phorton1/Arduino-boat-airco/docs/3dp/drain_straight_top.3mf

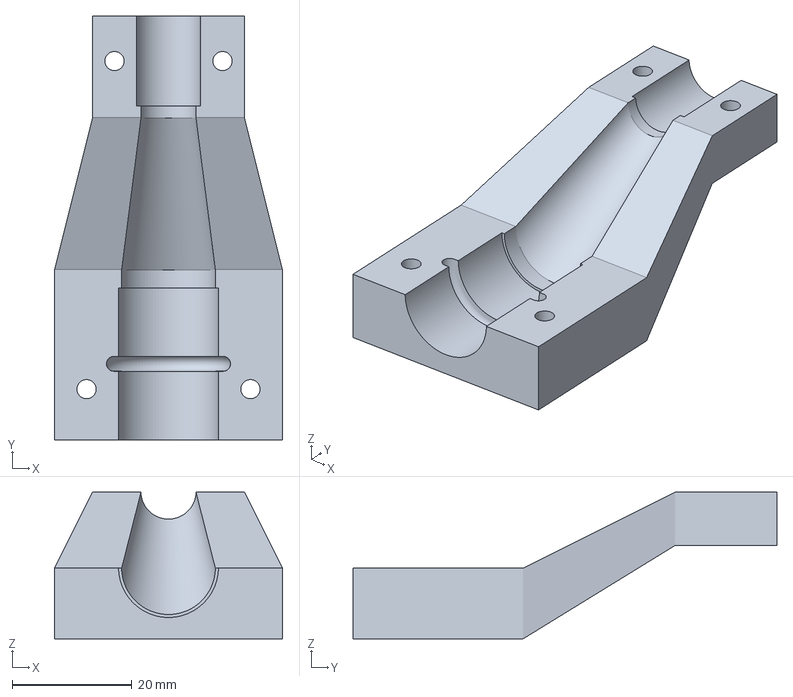
[picture p1: CAD file, 2026-03-28]
docs/3dp/drain_straight_top.3mf
38.1 x 70.8 x 24.5 mm
