phorton1/Arduino-boat-airco/docs/3dp/drain_angled_top.3mf

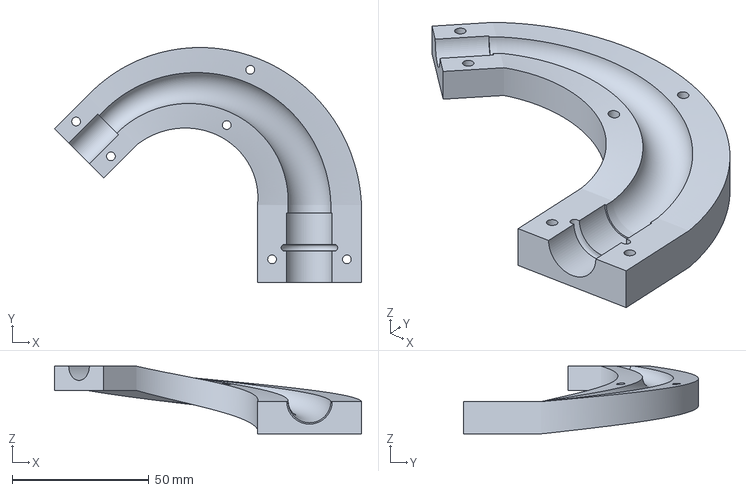
[picture p2: CAD file, 2026-03-28]
docs/3dp/drain_angled_top.3mf
112.4 x 86.0 x 24.8 mm
