phorton1/Arduino-boat-airco/docs/3dp/closet_box_cover.3mf

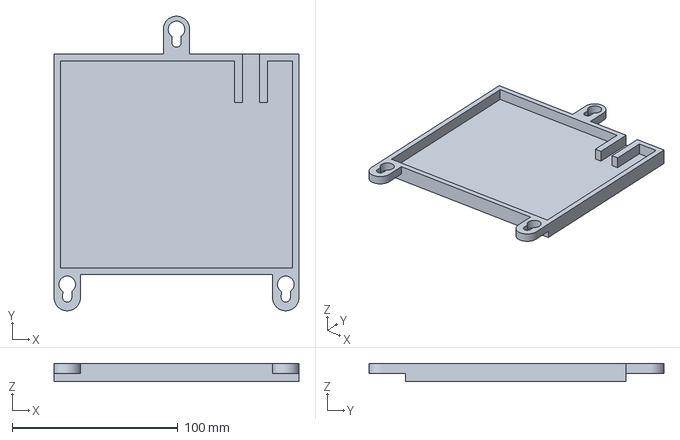
[picture p3: CAD file, 2026-03-28]
docs/3dp/closet_box_cover.3mf
148.0 x 178.0 x 11.0 mm
