phorton1/Arduino-boat-airco/docs/3dp/drain_straight_bottom.3mf

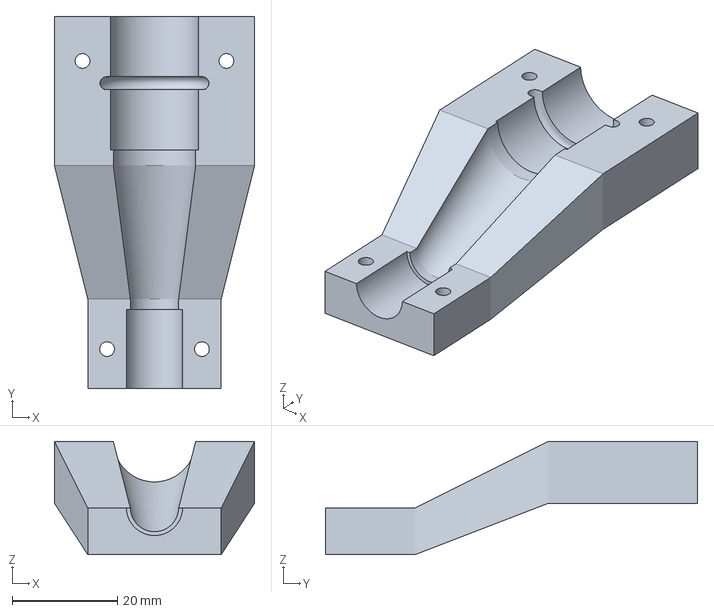
[picture p4: CAD file, 2026-03-28]
docs/3dp/drain_straight_bottom.3mf
38.1 x 70.8 x 21.6 mm
