phorton1/Arduino-boat-airco/docs/3dp/led_holder.3mf

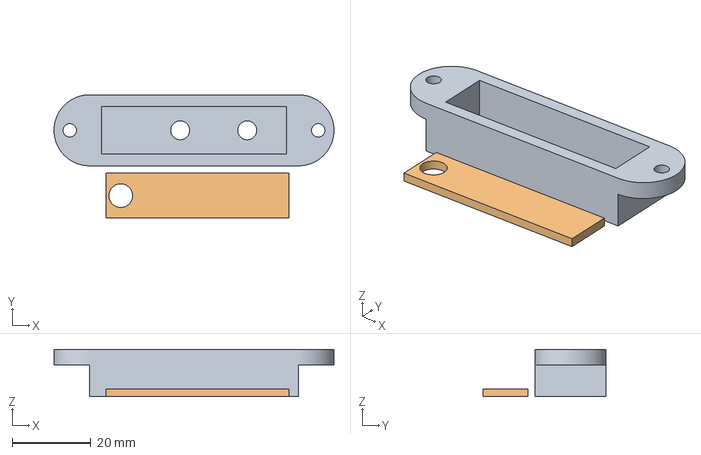
[picture p5: CAD file, 2026-03-04]
docs/3dp/led_holder.3mf
71.0 x 31.3 x 12.0 mm
led_holder.stl
led_holder2.stl
