phorton1/Arduino-boat-airco/docs/3dp/sensor_clamp.stl

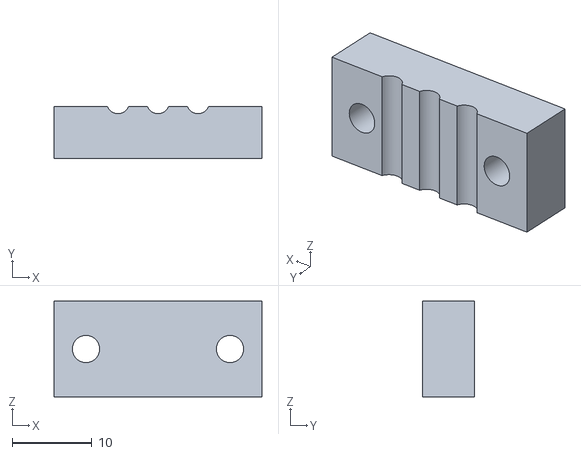
[picture p6: CAD file, 2026-03-04]
docs/3dp/sensor_clamp.stl
26.0 x 6.50 x 12.0
