phorton1/Arduino-boat-airco/docs/3dp/led_holder2.stl

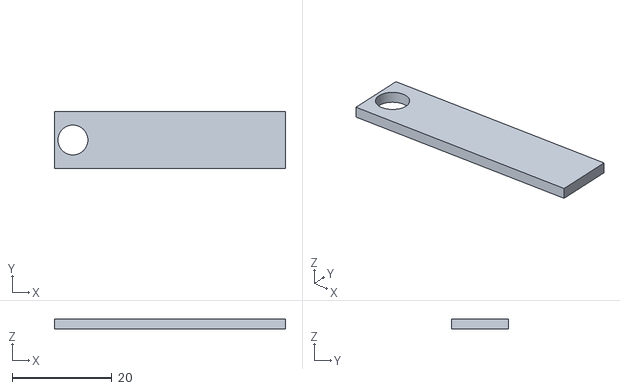
[picture p7: CAD file, 2026-03-04]
docs/3dp/led_holder2.stl
46.4 x 11.4 x 2.00
