phorton1/Arduino-boat-airco/docs/3dp/sensor_inside.stl

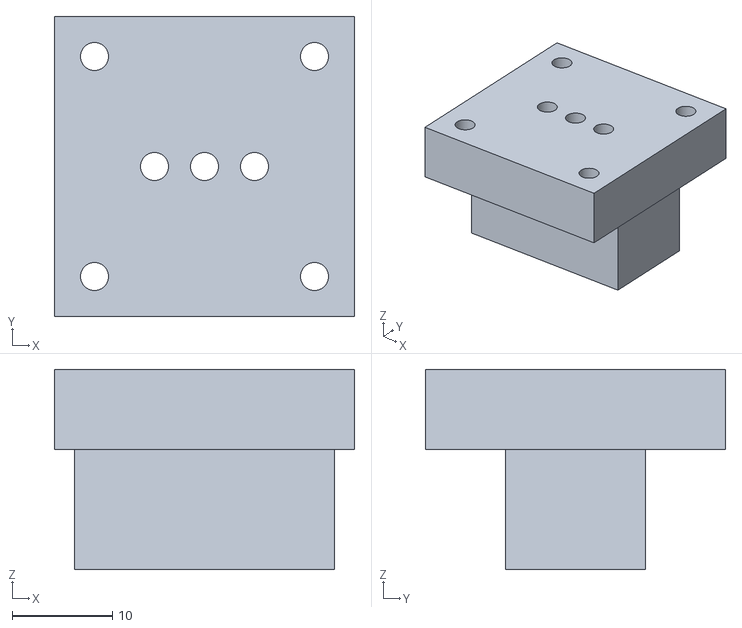
[picture p8: CAD file, 2026-03-04]
docs/3dp/sensor_inside.stl
30.0 x 30.0 x 20.0
