phorton1/Arduino-boat-airco/docs/3dp/drain_box_parts.3mf

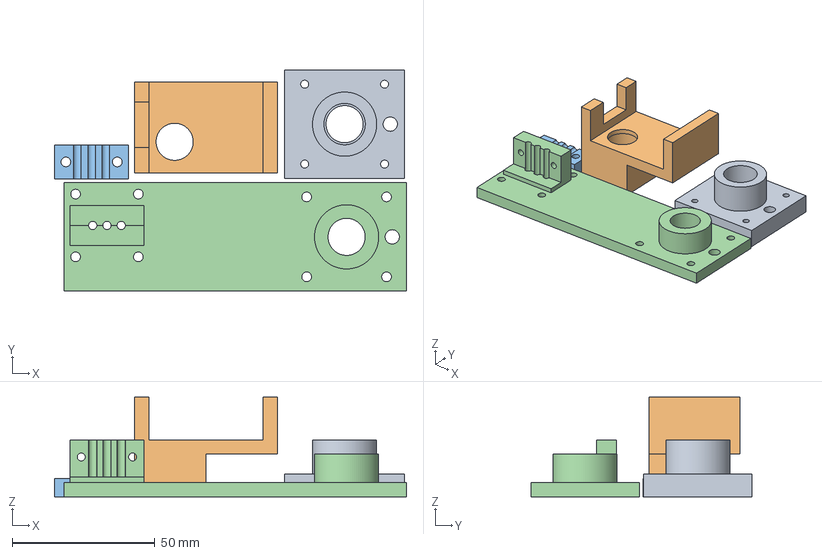
[picture p9: CAD file, 2026-03-04]
docs/3dp/drain_box_parts.3mf
123.4 x 77.5 x 35.0 mm
drain_pump_inside.stl
drain_pump_top.stl
sensor_clamp.stl
drain_box_top.stl
