phorton1/Arduino-boat-airco/docs/3dp/hole_template.stl

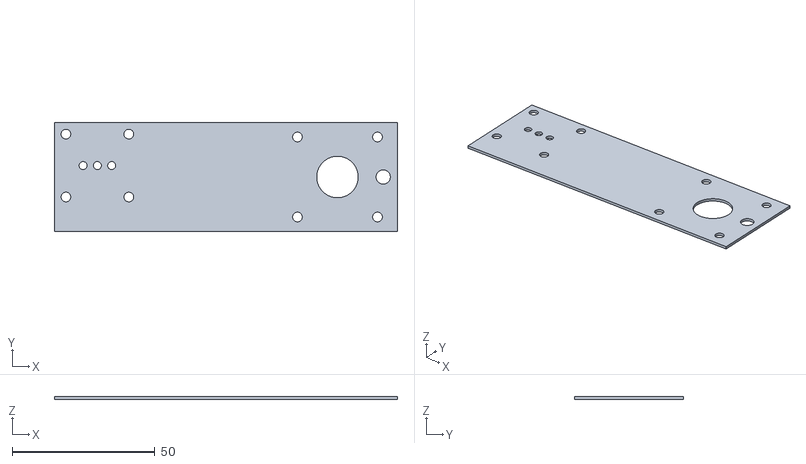
[picture p10: CAD file, 2026-03-04]
docs/3dp/hole_template.stl
120.0 x 38.0 x 1.00
