phorton1/Arduino-boat-airco/docs/3dp/drain_pump_inside.stl

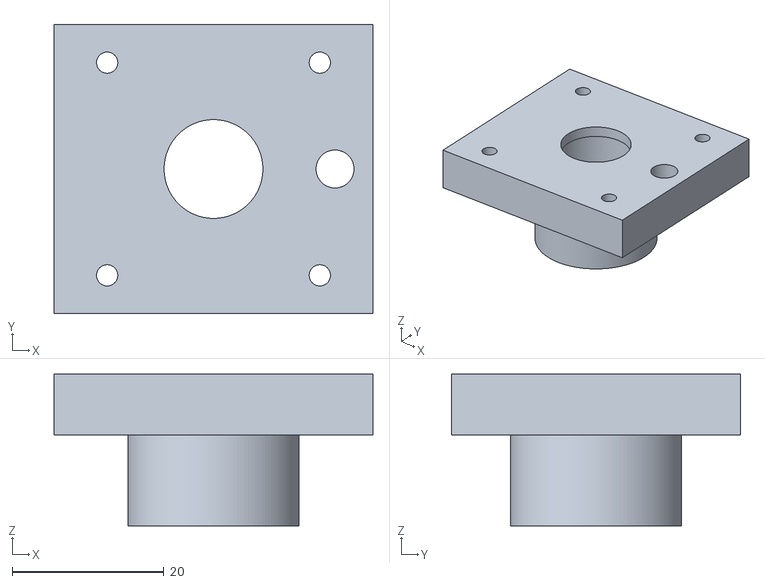
[picture p11: CAD file, 2026-03-04]
docs/3dp/drain_pump_inside.stl
42.0 x 38.0 x 20.0
