phorton1/Arduino-boat-airco/docs/3dp/drain_pump_top.stl

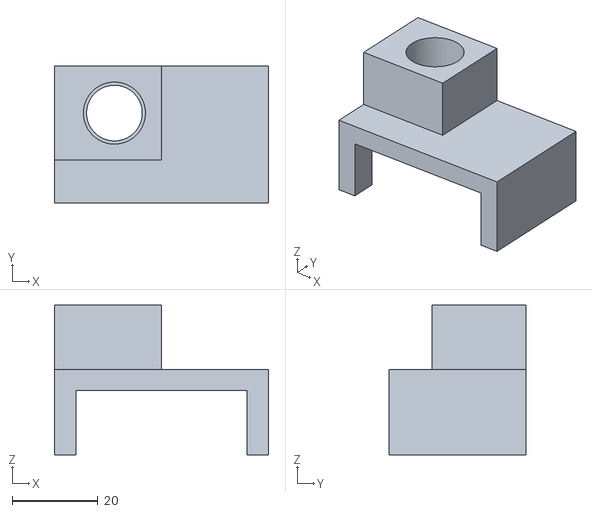
[picture p12: CAD file, 2026-03-04]
docs/3dp/drain_pump_top.stl
50.0 x 32.0 x 35.0
