phorton1/Arduino-boat-airco/docs/3dp/airco_controller_bottom.3mf

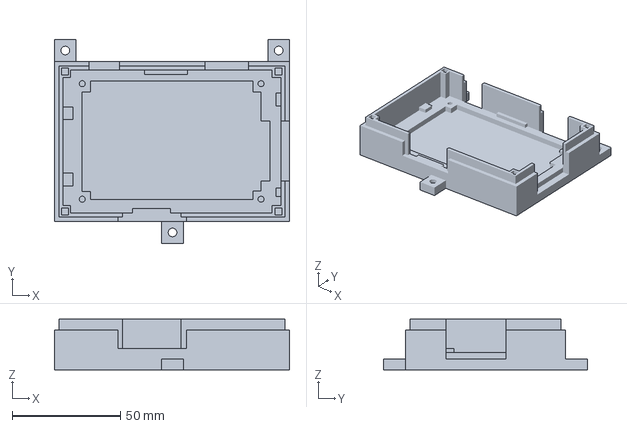
[picture p13: CAD file, 2026-03-02]
docs/3dp/airco_controller_bottom.3mf
108.5 x 94.0 x 23.5 mm
