phorton1/Arduino-boat-airco/docs/3dp/airco_controller_top.3mf

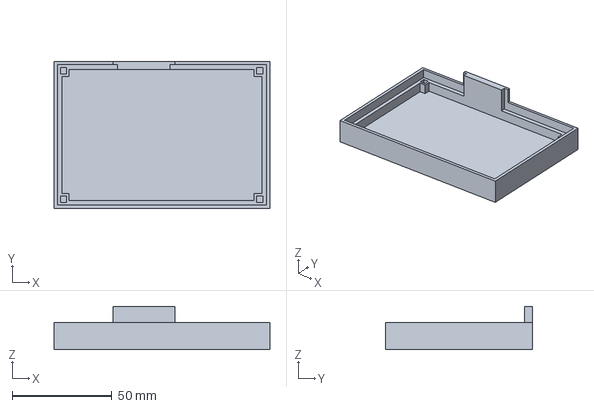
[picture p14: CAD file, 2026-03-02]
docs/3dp/airco_controller_top.3mf
108.5 x 74.0 x 21.7 mm
