phorton1/Arduino-boat-airco/(list of files, cad)

Other CAD files:
docs/3dp/drain_angled_top_mirror.3mf
docs/3dp/airco_box.f3d
docs/3dp/airco_controller_bottom.stl
docs/3dp/airco_controller_top.stl
docs/3dp/closet_box_cover.stl
docs/3dp/led_holder.stl
