phorton1/Arduino-boat-airco/docs/kicad/board1/board1.kicad_pcb

## KiCad design docs/kicad/board1/board1.kicad_pcb (2026-03-02)

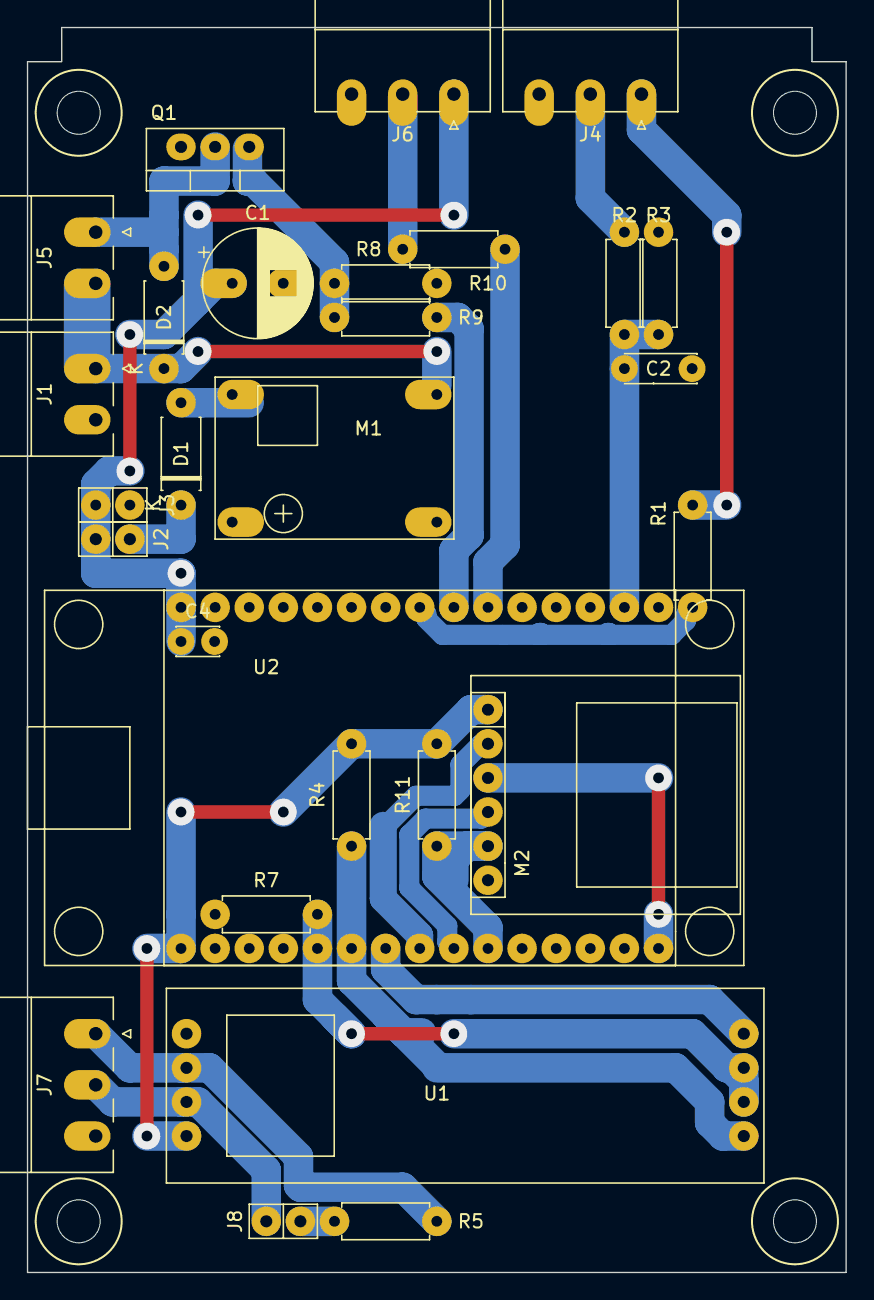
[picture p15: board board1.kicad_pcb from above]

Board: 2 copper layers, 61.0 x 92.7 mm, 28 parts (0 on the bottom side), 25 nets.

Parts:
C1: 100uf; CP_my100uf
C2: 2.2uf; myCapTantulum2
C4: 0.1uf; myCapCeramicSmall
D1: 1N4003; myDiodeSchotsky
D2: 1N5818; myDiodeSchotsky
J1: 12 IN; myPheonix2x3.81_right
J2: 5V Jump; myPinHeader_1x02
J3: 5V Test; myPinSocket_1x02
J4: SENSOR; myPheonix3x3.81_right
J5: PUMP; myPheonix2x3.81_right
J6: WS2812_B; myPheonix3x3.81_right
J7: RS485; myPheonix3x3.81_right
J8: RS485_TERMINATOR; myPinHeader_1x02
M1: BUCK01; buck-mini360
M2: SD_TYP0; SDCardReader_flipped
Q1: IRLZ44N; TO-220-3_Vertical
R1, R2: 1K; myResistor
R3: 100K; myResistor
R4, R7, R10, R11: 10K; myResistor
R5: 120; myResistor
R8, R9: 220; myResistor
U1: RS485_MODULE; RS485_Module
U2: ESP32_DEV_0; myESP32DEV0

Connections:
+3V3: M2.6, R4.2, R11.2, U1.8, U2.30
+5V: C1.1, C4.1, J2.2, J3.2, J6.1, U2.1
DRIVE_ROD: J4.1, R1.1
GND: C1.2, C2.2, C4.2, J1.2, J3.1, J4.3, J6.3, J7.3, M1.1, M1.2, M2.1, Q1.3, R3.2, R7.2, R10.2, U1.5, U2.2, U2.29
MISO: M2.2, R11.1, U2.21
MOSI: M2.4, U2.16
unnamed: D1.1, J2.1
unnamed: D1.2, M1.3
unnamed: J6.2, R8.2
unnamed: J8.2, R5.1
unnamed: Q1.1, R9.2, R10.1
PUMP: R9.1, U2.9
PUMP+: D2.1, J1.1, J5.2, M1.4
PUMP-: D2.2, J5.1, Q1.2
RS485_A: J7.2, J8.1, U1.7
RS485_B: J7.1, R5.2, U1.6
RX2: R4.1, U1.1, U2.25
SCLK: M2.3, U2.22
SDCS: M2.5, U2.23
SENSOR: C2.1, R2.2, R3.1, U2.14
SENSOR_ROD: J4.2, R2.1
S_DRIVE: R1.2, U2.8
TX2: U1.4, U2.24
TX_EN: R7.1, U1.2, U1.3, U2.26
WS2812B: R8.1, U2.10
