phorton1/Arduino-boat-airco/(commit log)

2025-12-15 checked in strange gitMUI extra commit of /src/Arduino/boat/airco/data submodule commit
2025-12-18 submodule(data) auto_commit(1adaeb45) reworked iotChart.js incremental update scheme starting with Arduino-boat-drainPump
2025-12-18 starting in Arduino-boat-arirco, major rework of iotChart.js and how charts are implemented - use common chart.html instead of specific/extra_data/device_chart.html - eliminates need for extra_data/d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
    [airco.ino, aircoHistory.cpp]
2025-12-18 submodule(data) auto_commit(a4e2ed81) change chart.html and iotChart.js to use and remove style "degree_hidden" for devices that chart things with degrees
2026-02-22 myIOTHTTP.cpp: added special case to do token replacement for "data_name" in chart.html AND updated myIOT devices with charts to pass data_name in chart_link
    [airco.ino, aircoHistory.cpp]
2026-02-22 submodule(data) auto_commit(37a6a76c) added framework for chart.html to pass "data_name" to allow multiple charts per device; ALSO store most recent chart period in browser storage
2026-02-27 got rid of old drain_pump extra kicad stuff and created new combined airco PCB and designed box
    [board1.kicad_pcb, board1.sch]
2026-03-01 updated combined BOARD1 - single sensor, resistor silkscreen
    [board1.kicad_pcb, board1.sch]
2026-03-01 checkin board1 before milling
    [board1.kicad_pcb, board1.sch]
2026-03-02 build airco PCB and print box
    [airco_box.f3d, airco_controller_bottom.3mf, airco_controller_bottom.stl, airco_controller_top.3mf, airco_controller_top.stl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]
2026-03-02 update airco preferences.txt to COM6 for new ESP32 no-holes micro-usb
2026-03-03 Fix (re-implmenent) LOG_WINDOW filtering of drain level; minor fix Compressor mode byte
    [aircoData.cpp, aircoDrain.cpp]
2026-03-04 minor fix to drain pump LOG_WINDOW algorithm
    [aircoDrain.cpp]
2026-03-04 added some 3dp to airco before removing old drainPump repo
    [drain_box_parts.3mf, drain_pump_inside.stl, drain_pump_top.stl, hole_template.stl, led_holder.3mf, led_holder.stl, led_holder2.stl, sensor_clamp.stl]
2026-03-05 submodule(data) auto_commit(ecc76888) update myIOT data submodule readme.md to remove forward references to actual implmented device repos
2026-03-07 Added notion of "initial run" if !_time_last_run && millis()>_idle_time*1000 & m_sensor_avg>_idle_thresh; made CRC_ERRORS record with LOGE; turned on logfile on actual device
2026-03-28 3dp closet_box_cover; add .gitignore *.gcode; copy old drain_angled/strait from /dat/3d ... THAT FOLDER IS OBSOLETE
    [closet_box_cover.3mf, closet_box_cover.stl, drain_angled_top.3mf, drain_angled_top_mirror.3mf, drain_straight_bottom.3mf, drain_straight_top.3mf]
2026-04-03 re-ordered LEDs on startup - thre's a bug where one or both go off (black) after running a wile
    [airco.ino]
2026-04-03 "fix" new problem with LEDs going off when airco compressor/waterpum go on/off (?!?!) by updating pixels on any UI state change.
    [airco.h, airco.ino, aircoData.cpp]
2026-04-04 submodule(data) auto_commit(de0689cf) disable Scan/Delete endpoints and just View data records for devices that have graphs, but no SD card
2026-04-04 New Chart Tooltips and DataLog record maintenance feature in myIOT library and updated to all living devices appropriately
2026-04-06 fix minor bug in airco chart link dataname
    [airco.ino]
2026-06-28 submodule(data) auto_commit(eadab9ea) added myIOTDataLog type LOG_COL_TYPE_INT16_10 to support volts (fridgeController)
2026-09-11 submodule(data) auto_commit(6700b423) skip sample points with temperature sensor anomolies
2026-10-11 fix (dont log) bogus -40C intake/condensor temperaturs in data logs on reboot
2026-10-22 remedial changes to aircoHistory and drain_history.data; made config defaults match current settings and increased some config max values
